baidenm22/RC-Car-Project/Images and Videos/RenderedCircuit.png

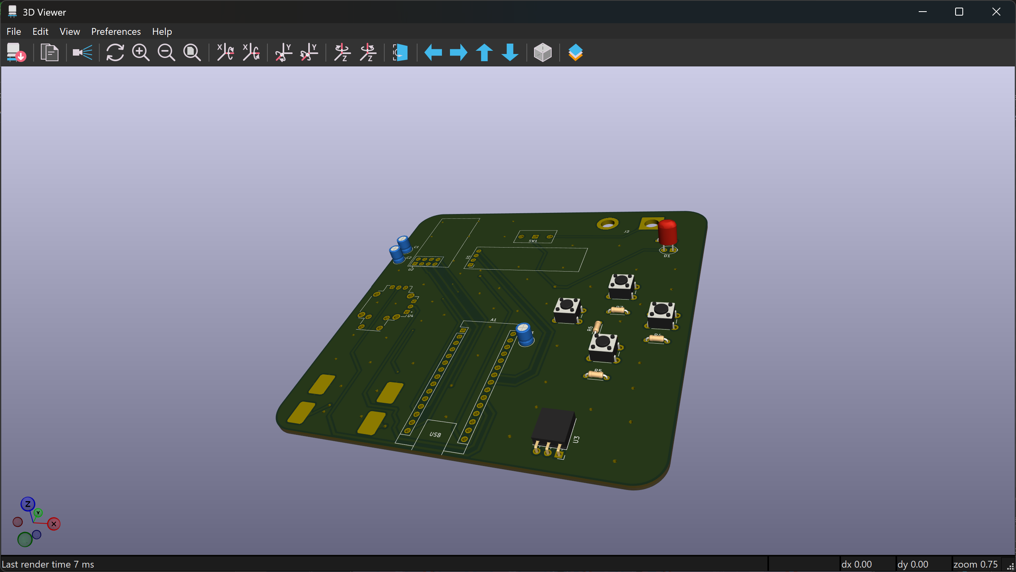
Images and Videos/RenderedCircuit.png
