baidenm22/RC-Car-Project/MiniRCCar.docx

RC Car Project

Aiden McBride, Henry Haight, Will Simmons

September 2026 - TBD

Learning Objectives:

2. Learn PCB design
3. Programming Arduino
4. Soldering
5. 3D Modeling
6. Learning Radio Frequencies
7. Learn AI

What needs to be done:

2. Program
3. Design Circuit
4. Choose parts
5. Assemble Circuit
6. Assemble Car

What are some features we can add?

1. Screen on controller to change modes/keep track of things (i.e points)
2. A sensor to allow the car to interact with the outside world (i.e finish line)
3. A finish line
4. Different game modes (think Mario Kart)

Research using ChaptGPT OpenAI:

Q: What kinds of boards should we use for our project?

A: There is a huge list of types of boards we can use. With the idea of a more compact design that allows for simple quick changes to the body of the car and limited connections an Arduino Nano should be good. Upon further research, there has been a developed Nano board with an RF chip integrated into its systems which can shrink the overall size of our electronics but at a higher price. Depending on what we want to do with the controller, such as an LCD screen, we may need to upgrade it to a more advanced board.

Q: How should we deal with differential gear?

A: We can completely avoid it using two motors instead of one to power each wheel separately. We also can go with just 2-wheel drive.

Q: How should we power the RC car?

A: We have some options. This involves using Lithium batteries (which require proper charging and care) or using AA/AAA batteries, which are safer and easier. We should also power the motors through the batteries and not the 5v pin on the Arduino to avoid interference when it turns on and off and the lack of current needed.

Q: How do we control the motor speeds?

A: Use PWM to control the motor speeds through a dual H-bridge motor driver. Chat recommends the DRV8833 because it's compact for small DC motors. This allows us to have the motors separate and use the Arduino to only control how much power the motors get.

Q: How should we use a servo for controlling the direction of the car?

A: We would only use the motors at the same speed and use the servo that is attached to a steering linkage. We would avoid using all 180 degrees. Using to much will cause strain and cause the servo to draw more current. Chat recommends connecting it to a regulated 5-6v.

Q: What kind of sensor should we add to detect a finish?

A: Chat suggests that we use an IR sensor because it can be used in many forms to detect if a car finishes a race. Since we want our car to do other things, it suggests we use it on the car itself.

Q: What kind of screen should we use for the controller?

A: We should use the I2C LCD, which only needs four pins to control it. This would be ideal to allow us to stick with an Arduino Nano.

Q: How should we use the nRF24L01 in our design

A: When we connect it to the Arduino Nano, we need to make sure we add a capacitor to prevent it from receiving interference from the servo and motors. We also need to make sure it's connected to the 3.3V pin and D13-D11. We can use a Struct to create a package to send to the car and for the car to receive.

Current Part List:

Car - 1 Arduino Nano - 1 nRF24L01 - 2 motors - 1 Servo - 1 IR Sensor - Motor Driver (H-Bridge) - 1 5v Voltage Regulator | Controller - 1 Arduino Nano - 1 nRF24L01 - 1 L2C LCD - 1 Joystick - 4 Buttons - 1 5V Voltage Regulator

Circuit design/Picking Items

With a quick Google search and by following this blog (In-Depth: Control DC Motors with L293D Motor Driver IC & Arduino), this is how we use an H-bridge to control two motors. Here is the pinout of the suggested DRV8833, which should use a similar method to power the motors in our RC car circuit. This blog shows how to use the DRV8833 with a double motor setup Controlling DC Motors with DRV8833 Motor Driver and Arduino (https://lastminuteengineers.com/drv8833-arduino-tutorial/)

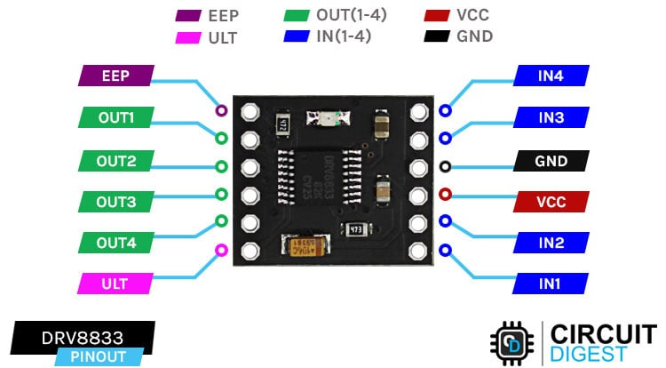
[picture p3: figure]
Interfacing DRV8833 Dual Motor Driver Module with Arduino
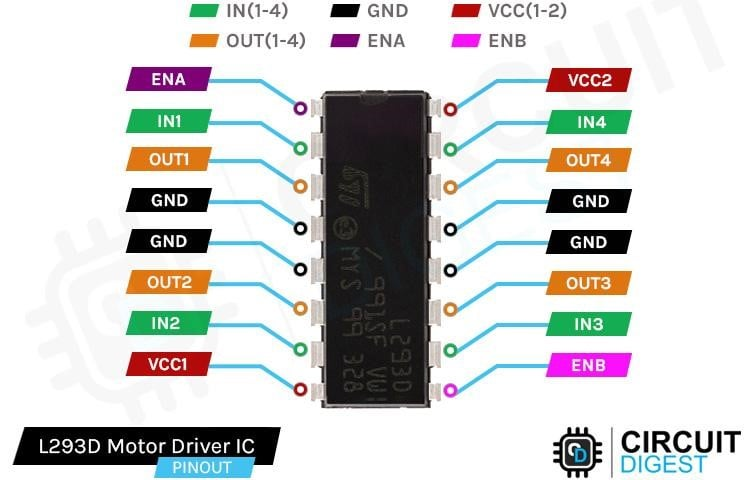
[picture p4: figure]
Control DC Motors with Arduino and L293D Motor Driver IC
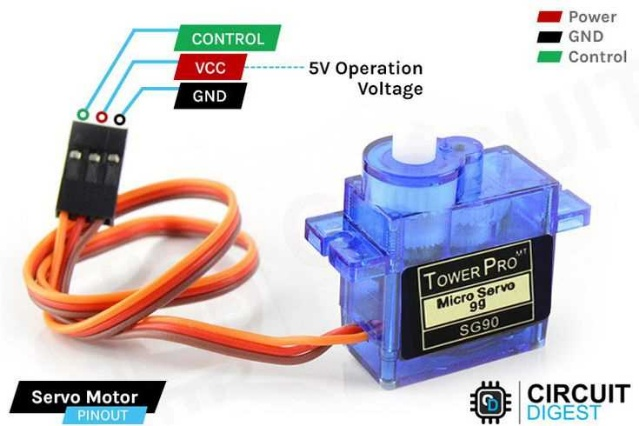
[picture p5: figure]
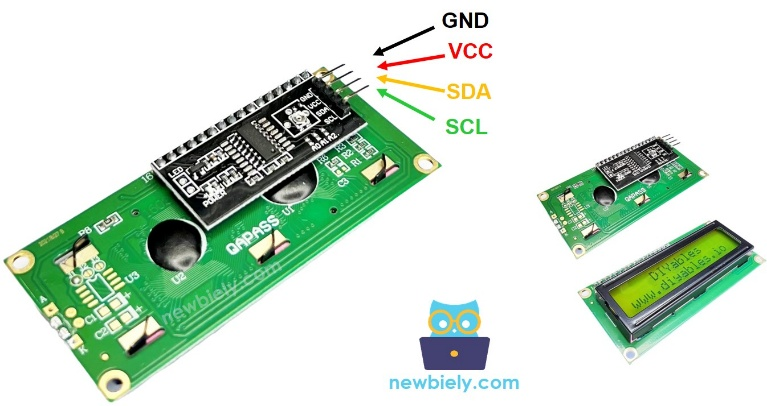
[picture p6: figure]
Arduino UNO R4 - LCD I2C | Arduino UNO R4 Tutorial
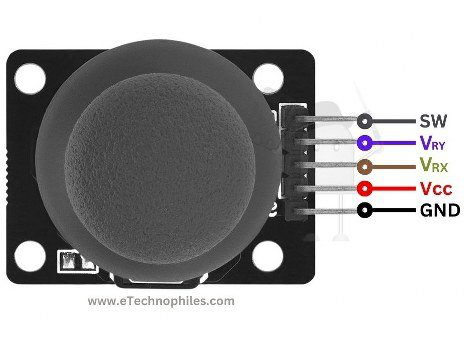
[picture p7: figure]
Joystick Module with Arduino- 2 Cool Projects
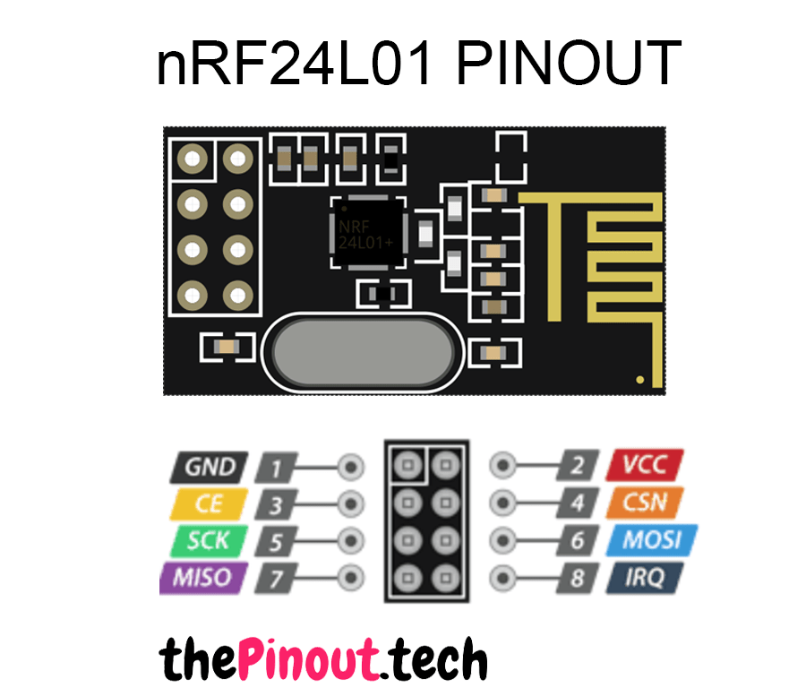
[picture p8: figure]
nRF24L01 Pinout » DIY Usthad
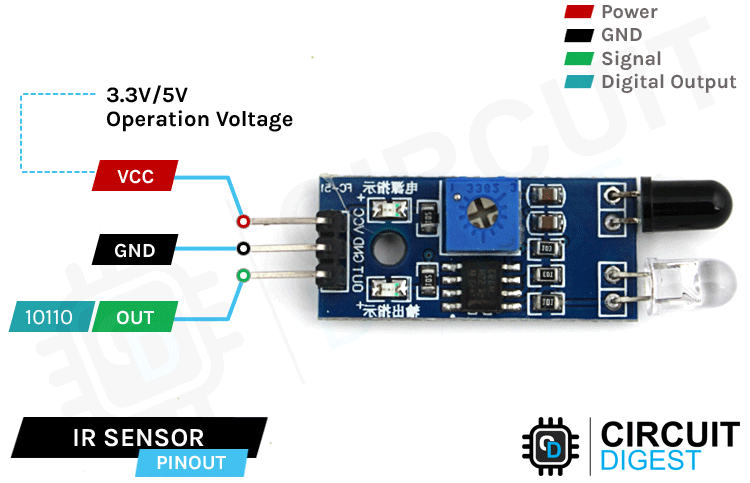
[picture p9: figure]
Diy Ir Sensor Module Circuit Diagram
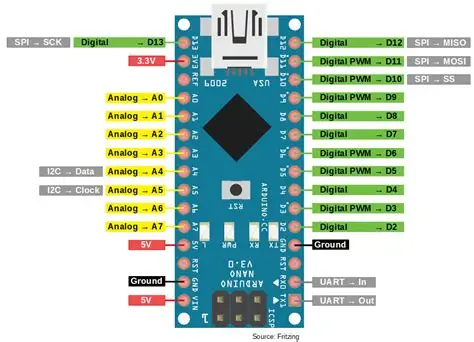
[picture p10: figure]

Pin Connections (Arduino)

VIN | 5v Regulator | VIN | 5v Regulator
GND | GND | GND | GND
3.3V | nRF24l01 VCC | 3.3V | nRF24l01 VCC
D13 | nRF24l01 SCK | D13 | nRF24l01 SCK
D12 | nRF24l01 MISO | D12 | nRF24l01 MISO
D11 | nRF24l01 MOSI | D11 | nRF24l01 MOSI
D10 | Right Motor INPUT 1 | D10 | nRF24l01 CSN
D9 | Right Motor INPUT 2 | D9 | nRF24l01 CE
D8 | nRF24l01 CSN | D8 | Button 1
D7 | nRF24l01 CE | D7 | Button 2
D6 | Servo Instructions | D6
D5 | Right Motor PWM Speed | D5 | L2C LCD SDA
D4 | IR Sensor INPUT | D4 | L2C LCD SCL
D3 | Left Motor PWM Speed | D3 | Button 3
D2 | Left Motor INPUT 3 | D2 | Button 4
D1 | Left Motor INPUT 4 | D1 | Joystick button SW
| | A1 | Joystick VRY
| | A2 | Joystick VRX

Starting

Since we want to know how everything will work together and be able to better tie everything together, we have bought the components we believe we will need and will test them separately and then together. We are going to start with the controller because we believe that it will be easier to set up, and we can find a solution to powering it more easily and better before moving to the more power-dependent build of the RC car.

10-22

The first thing we tried was setting up the buttons. While we worked on our breadboard, we noticed some weird issues; moving to a different breadboard solved the issue with bad connections. We tried the buttons with and without pull-down resistors to check the result. We were able to successfully read inputs from all four buttons.

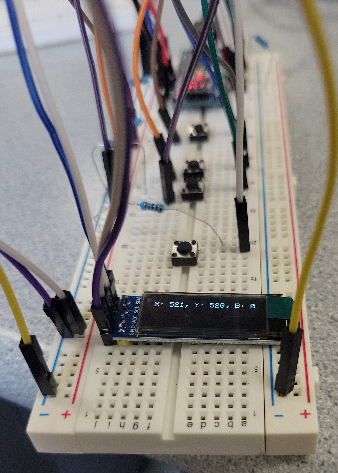
[picture p11: figure]

Next, we attached the joystick we have. Using the same code, we were able to read the many different values of the joystick movement. We did have an issue where we needed to connect the joystick button to a different pin to allow for serial communication. We also noticed that we are required to have a pull-down resistor on the joystick button to make it work. This makes sense.

Next up is the OLED display. We watched this video on how to set up our OLED display: youtube.com/watch?v=uA6DbLMcWhU&feature=youtu.be. After reviewing the video, we installed the needed libraries and were able to successfully display the data we were receiving from the buttons and joystick! We also learned the OLED uses A4 and A5 pins, so we need to change our pinout; luckily, this allows us to connect the button on the Joystick

10-24

This time we went with using the RF chip to connect two Arduinos together. After quickly downloading the RF24 library and looking at the code, we learned we need to change the button layouts to be able to use the RF24. This was no big issue, and after learning about the quick write function with the help of AI, we were able to connect our Arduino to another Arduino while still having the ability to use SPI communication!

10-27

This day we needed to find the solution to our most challenging problem: powering. After a lot of AI and discussion, we determined we would use three AAA batteries for the controller. It will pass through a power XL3608 to go from 4.5v to 5.0v and then from 5 V to 3.3v through an AMS1117

We also started looking for the footprints to create a PCB. We would like to design a PCB to avoid the annoying connection to the RF and allow us to create a finished product.

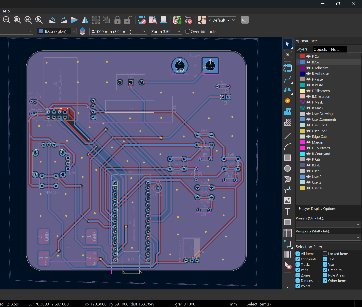
[picture p12: figure]

10-5

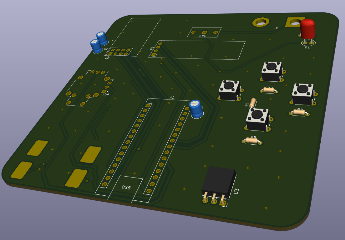
[picture p13: figure]

As we waited for our components to arrive, we started to create our first iterations of the PCB. During this process, we decided that it would be a good idea to include an indicator light. We also chose THT to make it easier to practice our soldering skills.

11-12

The parts have finally arrived. We measured our components and created custom footprints for our switch and XL3608 board that we will solder on. We also added these components to our breadboard and measured their voltage to verify it was safe to connect to our radio and Arduino. After a quick check, we tried it out, and it worked! To avoid problems with noise and inconsistent voltage, we added decoupling capacitors.
