baidenm22/RC-Car-Project/Images and Videos/Finished Circuit Back.png

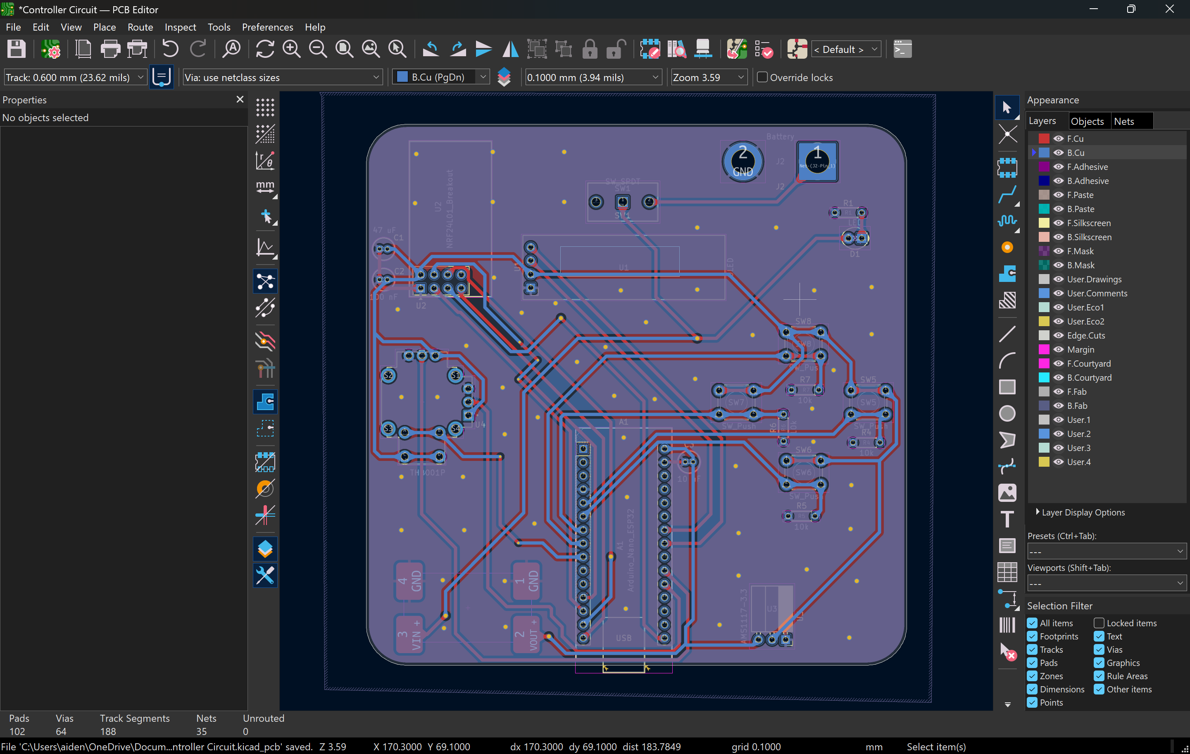
Images and Videos/Finished Circuit Back.png
