baidenm22/RC-Car-Project/Images and Videos/Finished Circuit Front.png

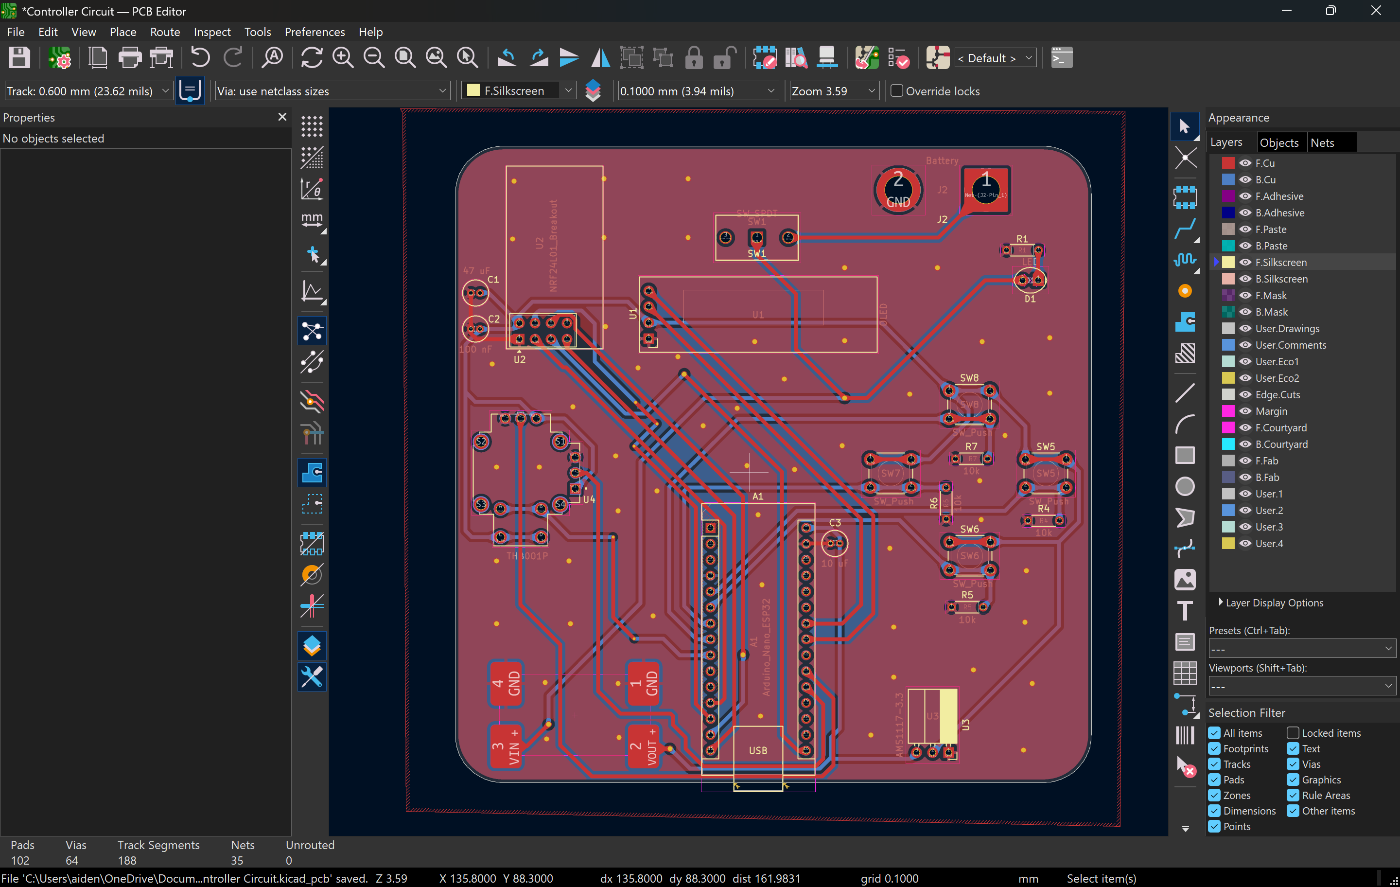
Images and Videos/Finished Circuit Front.png
