baidenm22/RC-Car-Project/Circuits/Controller Circuit/Controller Circuit/Controller Circuit.kicad_pcb

## KiCad design Circuits/Controller Circuit/Controller Circuit/Controller Circuit.kicad_pcb (2026-11-13)

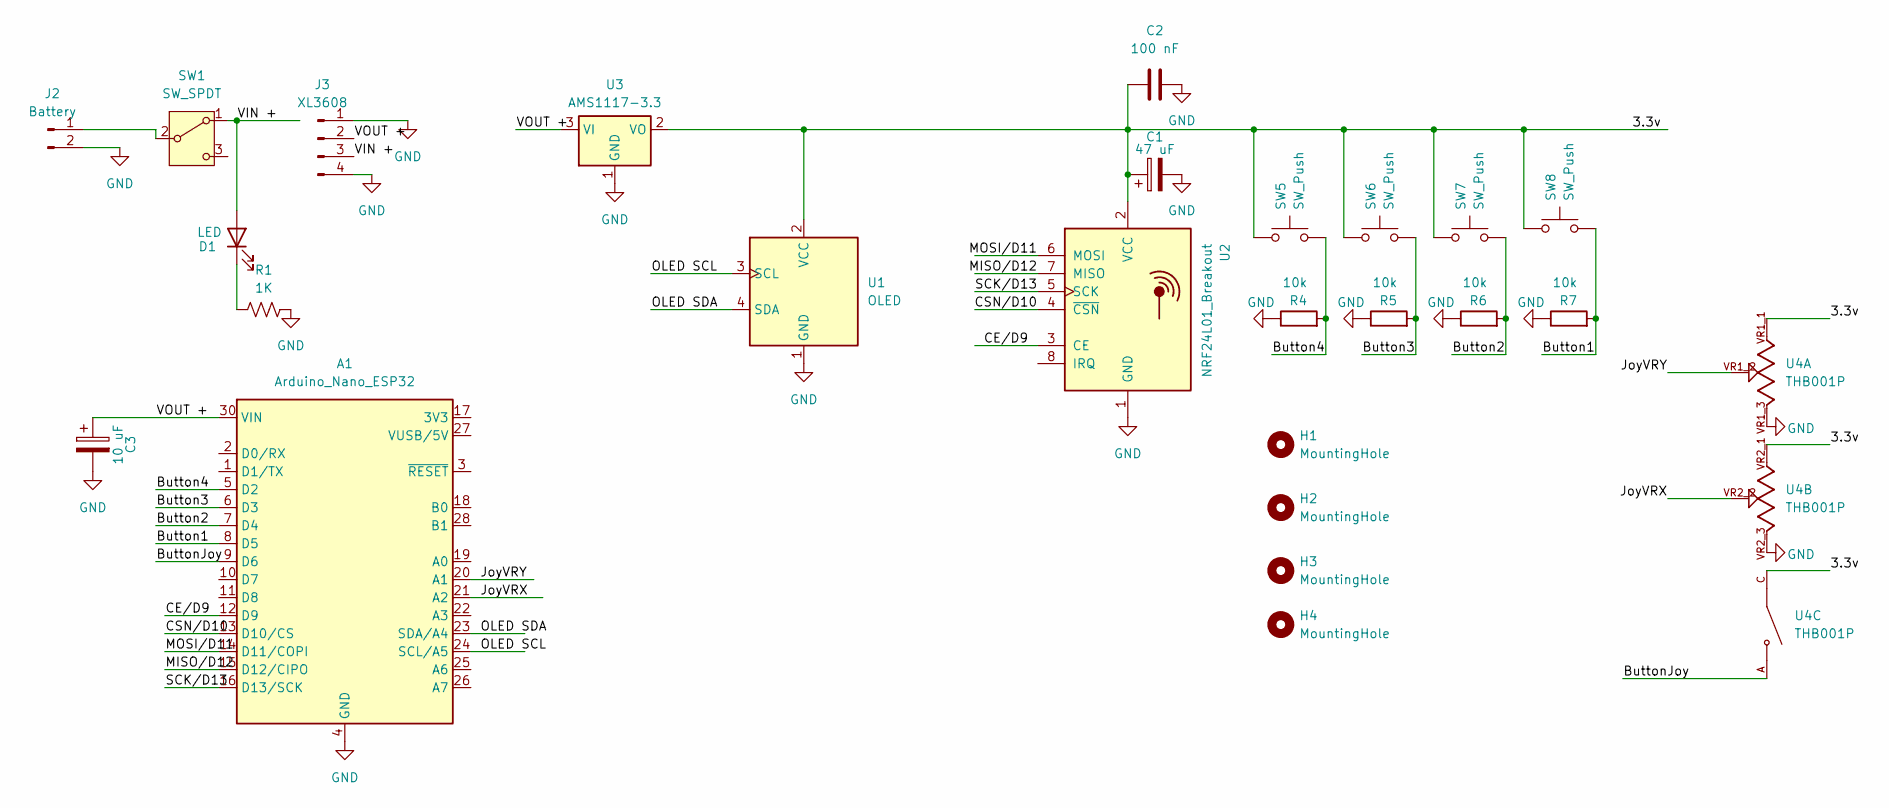
[picture p18: schematic Controller Circuit.kicad_sch]

Parts:
A1: Arduino_Nano_ESP32; Arduino_Nano
C1: 47 uF; CP_Radial_D8.0mm_P3.50mm
C2: 100 nF; C_Disc_D4.7mm_W2.5mm_P5.00mm
C3: 10 uF; CP_Radial_D5.0mm_P2.50mm
D1: LED; LED_Oval_W5.2mm_H3.8mm
H1, H2, H3, H4: MountingHole; MountingHole_3.2mm_M3
J2: Battery; SolderWire-0.1sqmm_1x02_P3.6mm_D0.4mm_OD1mm
J3: XL3608; 5V Booster
R1: 1K; R_Axial_DIN0204_L3.6mm_D1.6mm_P5.08mm_Horizontal
R4, R5, R6, R7: 10k; R_Axial_DIN0204_L3.6mm_D1.6mm_P5.08mm_Horizontal
SW1: SW_SPDT; SW_Slide_10mm
SW5, SW6, SW7, SW8: SW_Push; SW_PUSH_6mm
U1: OLED; ER_OLEDM0.91_1x-I2C
U2: NRF24L01_Breakout; nRF24L01_Breakout
U3: AMS1117-3.3; PinSocket_1x03_P2.54mm_Horizontal
U4: THB001P; CNK_THB001P; MPN THB001P

Connections:
/3.3v: C1.1, C2.2, SW5.1, SW6.1, SW7.1, SW8.1, U1.2 (VCC), U2.2 (VCC), U3.2 (VO), U4.C, U4.D, U4.VR1_1, U4.VR2_1
/Button1: A1.8 (D5), R7.2, SW8.2
/Button2: A1.7 (D4), R6.2, SW7.2
/Button3: A1.6 (D3), R5.2, SW6.2
/Button4: A1.5 (D2), R4.2, SW5.2
/ButtonJoy: A1.9 (D6), U4.A, U4.B
/CE/D9: A1.12 (D9), U2.3 (CE)
/CSN/D10: A1.13 (D10/CS), U2.4 (~CSN)
/JoyVRX: A1.21 (A2), U4.VR2_2
/JoyVRY: A1.20 (A1), U4.VR1_2
/MISO/D12: A1.15 (D12/CIPO), U2.7 (MISO)
/MOSI/D11: A1.14 (D11/COPI), U2.6 (MOSI)
/OLED SCL: A1.24 (SCL/A5), U1.3 (SCL)
/OLED SDA: A1.23 (SDA/A4), U1.4 (SDA)
/SCK/D13: A1.16 (D13/SCK), U2.5 (SCK)
/VIN +: D1.2 (A), J3.3, SW1.1 (A)
/VOUT +: A1.30 (VIN), C3.1, J3.2, U3.3 (VI)
GND: A1.4 (GND), A1.29 (GND), C1.2, C2.1, C3.2, J2.2, J3.1, J3.4, R1.2, R4.1, R5.1, R6.1, R7.1, U1.1 (GND), U2.1 (GND), U3.1 (GND), U4.VR1_3, U4.VR2_3
unnamed: D1.1 (K), R1.1
unnamed: J2.1, SW1.2 (B)

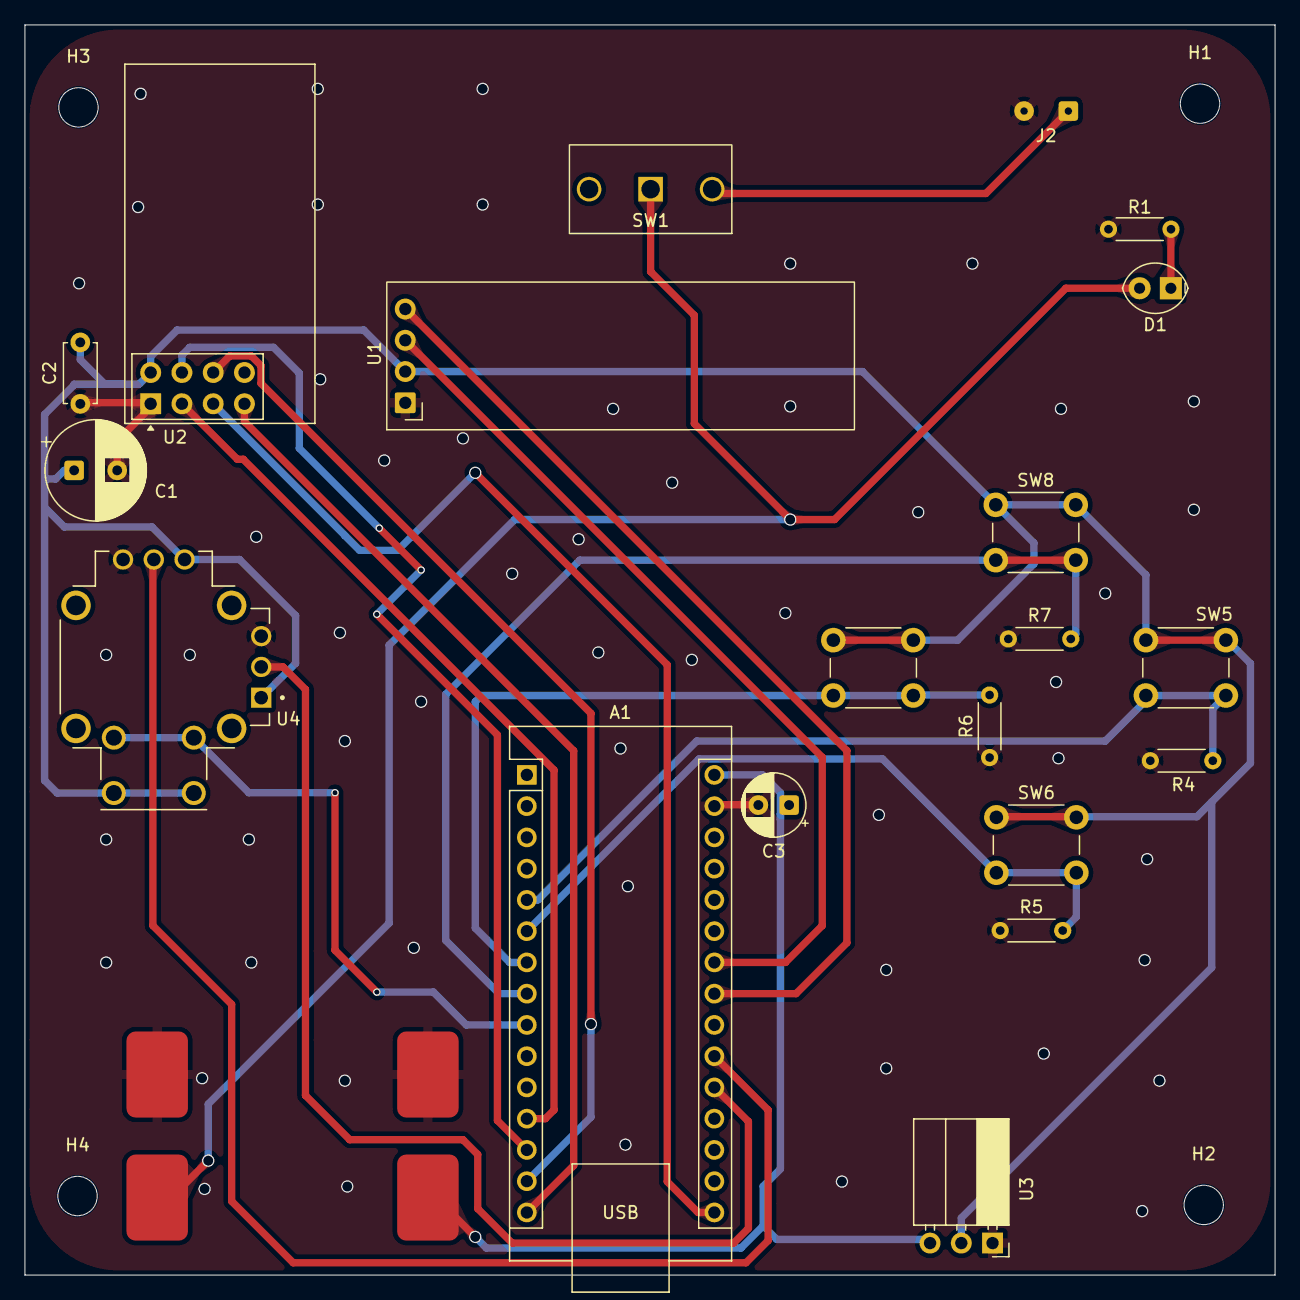
[picture p19: board Controller Circuit.kicad_pcb from above]

Board: 2 copper layers, 101.6 x 101.6 mm, 25 parts (0 on the bottom side), 20 nets.
