baidenm22/RC-Car-Project/Circuits/RCCarCircuits/MiniRCCAR.kicad_pcb

## KiCad design Circuits/RCCarCircuits/MiniRCCAR.kicad_pcb (2026-10-15)



Board: 2 copper layers, 43.2 x 17.8 mm, 6 parts (2 on the bottom side), 2 nets, no tracks yet.

Parts:
J1: Analog; PinHeader_1x15_P2.54mm_Vertical
J2: Digital; PinHeader_1x15_P2.54mm_Vertical
MH1, MH2, MH3, MH4: MountingHole_65mil

Connections:
/~RESET: J1.13, J2.13
GND: J1.14, J2.12
