baidenm22/RC-Car-Project/Code/LightBlink/LightBlink.ino

void setup() {
  // put your setup code here, to run once:
  pinMode(2,OUTPUT);
  Serial.begin(9600);
  Serial.println("Success");
}

void loop() {
  // put your main code here, to run repeatedly:
  digitalWrite(2,HIGH);
  delay(2000);
  digitalWrite(2,LOW);
  Serial.println("Success");
  delay(2000);
}
