baidenm22/RC-Car-Project/(commit log)

2026-10-16 Reorganize circuits file
2026-10-22 Update README with project components and connections
    Added sections detailing required components and current connections for the project.
2026-10-25 make all connections on KiCAD
2026-10-28 Add regulators and boosters to schematics and footprints for other parts
2026-11-06 Started making PCB
2026-11-09 Finish PCB
2026-11-13 PCB Edits
    Added Decoupling Capacitors and rerouted the PCB to better size it
