baidenm22/RC-Car-Project/Images and Videos/OLED.jpg

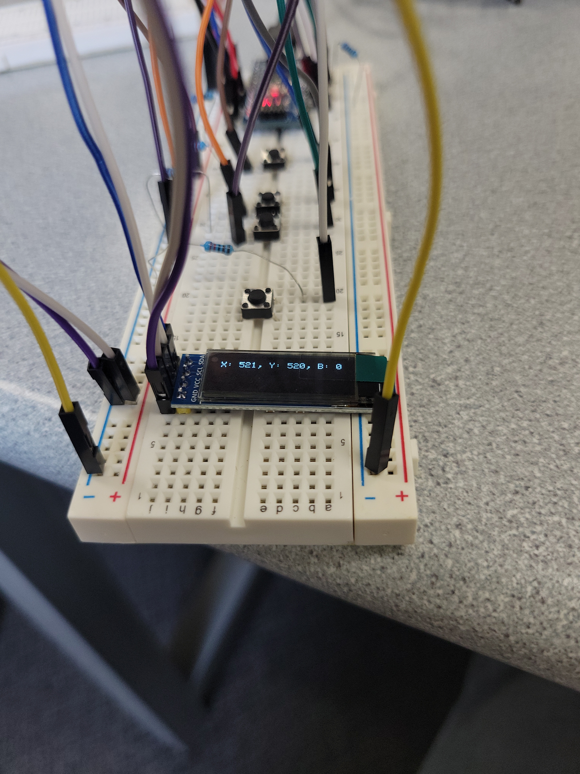
Images and Videos/OLED.jpg
