baidenm22/RC-Car-Project/Images and Videos/WorkingVideo.jpg

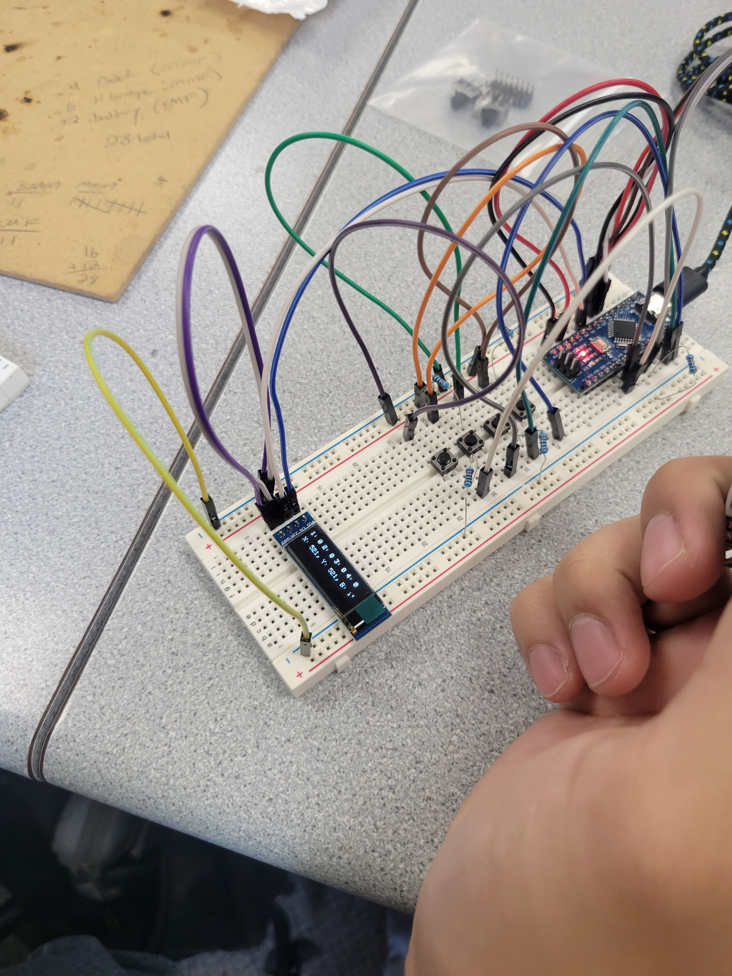
Images and Videos/WorkingVideo.jpg
