baidenm22/RC-Car-Project/Images and Videos/ButtonsConnection.jpg

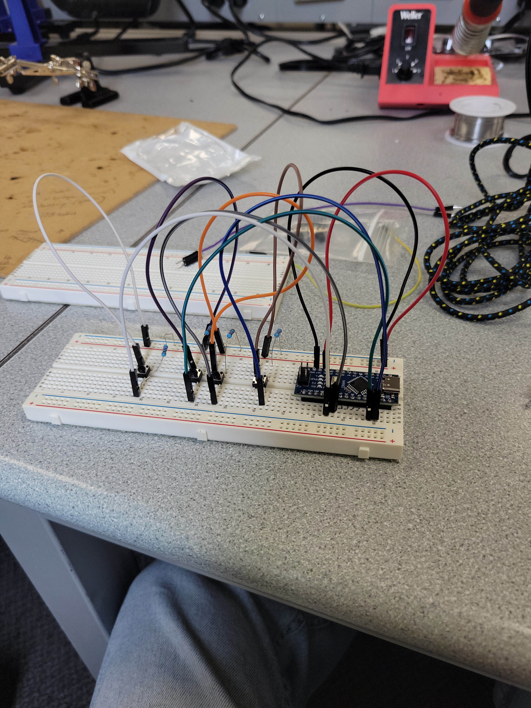
Images and Videos/ButtonsConnection.jpg
